AXE-jp/ros2rapper/src/ether/verilog-ethernet/verilog_ethernet.v

// Copyright (c) 2021-2024 AXE, Inc.
// SPDX-License-Identifier: GPL-3.0-or-later

`resetall
`default_nettype none

`include "ros2_ether_config.vh"

module verilog_ethernet (
    input  wire        clk,
    input  wire        rst_n,
    input  wire        enable,

    input  wire        phy_rx_clk,
    input  wire [3:0]  phy_rxd,
    input  wire        phy_rx_dv,
    input  wire        phy_rx_er,
    input  wire        phy_tx_clk,
    output wire [3:0]  phy_txd,
    output wire        phy_tx_en,
    output wire        phy_reset_n,

    input  wire        tx_udp_hdr_valid,
    output wire        tx_udp_hdr_ready,
    input  wire [5:0]  tx_udp_ip_dscp,
    input  wire [1:0]  tx_udp_ip_ecn,
    input  wire [15:0] tx_udp_ip_length,
    input  wire [7:0]  tx_udp_ip_ttl,
    input  wire [7:0]  tx_udp_ip_protocol,
    input  wire [31:0] tx_udp_ip_source_ip,
    input  wire [31:0] tx_udp_ip_dest_ip,
    input  wire [15:0] tx_udp_source_port,
    input  wire [15:0] tx_udp_dest_port,
    input  wire [15:0] tx_udp_length,
    input  wire [15:0] tx_udp_checksum,
    input  wire [7:0]  tx_udp_payload_axis_tdata,
    input  wire        tx_udp_payload_axis_tvalid,
    output wire        tx_udp_payload_axis_tready,
    input  wire        tx_udp_payload_axis_tlast,
    input  wire        tx_udp_payload_axis_tuser,

    output wire        rx_ip_hdr_valid,
    input  wire        rx_ip_hdr_ready,
    output wire [3:0]  rx_ip_version,
    output wire [3:0]  rx_ip_ihl,
    output wire [5:0]  rx_ip_dscp,
    output wire [1:0]  rx_ip_ecn,
    output wire [15:0] rx_ip_length,
    output wire [15:0] rx_ip_identification,
    output wire [2:0]  rx_ip_flags,
    output wire [12:0] rx_ip_fragment_offset,
    output wire [7:0]  rx_ip_ttl,
    output wire [7:0]  rx_ip_protocol,
    output wire [15:0] rx_ip_header_checksum,
    output wire [31:0] rx_ip_source_ip,
    output wire [31:0] rx_ip_dest_ip,
    output wire [7:0]  rx_ip_payload_axis_tdata,
    output wire        rx_ip_payload_axis_tvalid,
    input  wire        rx_ip_payload_axis_tready,
    output wire        rx_ip_payload_axis_tlast,
    output wire        rx_ip_payload_axis_tuser,

    input  wire [7:0]  tx_raw_eth_axis_tdata,
    input  wire        tx_raw_eth_axis_tvalid,
    output wire        tx_raw_eth_axis_tready,
    input  wire        tx_raw_eth_axis_tlast,

    input  wire        tx_raw_eth_ip_hdr_valid,
    output wire        tx_raw_eth_ip_hdr_ready,
    input  wire [5:0]  tx_raw_eth_ip_dscp,
    input  wire [1:0]  tx_raw_eth_ip_ecn,
    input  wire [15:0] tx_raw_eth_ip_length,
    input  wire [7:0]  tx_raw_eth_ip_ttl,
    input  wire [7:0]  tx_raw_eth_ip_protocol,
    input  wire [31:0] tx_raw_eth_ip_source_ip,
    input  wire [31:0] tx_raw_eth_ip_dest_ip,
    input  wire [7:0]  tx_raw_eth_ip_payload_axis_tdata,
    input  wire        tx_raw_eth_ip_payload_axis_tvalid,
    output wire        tx_raw_eth_ip_payload_axis_tready,
    input  wire        tx_raw_eth_ip_payload_axis_tlast,

    input  wire        select_tx_raw_eth_axis,
    input  wire        select_tx_raw_eth_ip,

    output wire [7:0]  rx_raw_eth_axis_tdata,
    output wire        rx_raw_eth_axis_tvalid,
    input  wire        rx_raw_eth_axis_tready,
    output wire        rx_raw_eth_axis_tlast,
    output wire        rx_raw_eth_axis_tuser,

    input  wire [47:0] local_mac,
    input  wire [31:0] local_ip,
    input  wire [31:0] gateway_ip,
    input  wire [31:0] subnet_mask,

    input  wire [5:0] arp_req_retry_count,
    input  wire [35:0] arp_req_retry_interval,
    input  wire [35:0] arp_req_timeout
);

wire [7:0] rx_axis_tdata;
wire rx_axis_tvalid;
wire rx_axis_tready;
wire rx_axis_tlast;
wire rx_axis_tuser;

wire [7:0] rx_ros2_axis_tdata;
wire rx_ros2_axis_tvalid;
wire rx_ros2_axis_tready;
wire rx_ros2_axis_tlast;
wire rx_ros2_axis_tuser;

wire [7:0] tx_axis_tdata;
wire tx_axis_tvalid;
wire tx_axis_tready;
wire tx_axis_tlast;
wire tx_axis_tuser;

wire [7:0] tx_ros2_axis_tdata;
wire tx_ros2_axis_tvalid;
wire tx_ros2_axis_tready;
wire tx_ros2_axis_tlast;
wire tx_ros2_axis_tuser;

wire rx_eth_hdr_ready;
wire rx_eth_hdr_valid;
wire [47:0] rx_eth_dest_mac;
wire [47:0] rx_eth_src_mac;
wire [15:0] rx_eth_type;
wire [7:0] rx_eth_payload_axis_tdata;
wire rx_eth_payload_axis_tvalid;
wire rx_eth_payload_axis_tready;
wire rx_eth_payload_axis_tlast;
wire rx_eth_payload_axis_tuser;

wire tx_eth_hdr_ready;
wire tx_eth_hdr_valid;
wire [47:0] tx_eth_dest_mac;
wire [47:0] tx_eth_src_mac;
wire [15:0] tx_eth_type;
wire [7:0] tx_eth_payload_axis_tdata;
wire tx_eth_payload_axis_tvalid;
wire tx_eth_payload_axis_tready;
wire tx_eth_payload_axis_tlast;
wire tx_eth_payload_axis_tuser;

wire [47:0] rx_ip_eth_dest_mac;
wire [47:0] rx_ip_eth_src_mac;
wire [15:0] rx_ip_eth_type;

assign phy_reset_n = rst_n;

eth_mac_mii_fifo #(
    .TX_FIFO_DEPTH(`MAC_TX_FIFO_DEPTH),
    .RX_FIFO_DEPTH(`MAC_RX_FIFO_DEPTH)
)
eth_mac_inst (
    .rst_n(rst_n),
    .logic_clk(clk),
    .logic_rst_n(rst_n),
    .logic_enable(enable),

    .tx_axis_tdata(tx_axis_tdata),
    .tx_axis_tvalid(tx_axis_tvalid),
    .tx_axis_tready(tx_axis_tready),
    .tx_axis_tlast(tx_axis_tlast),
    .tx_axis_tuser(tx_axis_tuser),
    .tx_axis_tkeep(1'b1),

    .rx_axis_tdata(rx_axis_tdata),
    .rx_axis_tvalid(rx_axis_tvalid),
    .rx_axis_tready(rx_axis_tready),
    .rx_axis_tlast(rx_axis_tlast),
    .rx_axis_tuser(rx_axis_tuser),
    .rx_axis_tkeep(),

    .mii_rx_clk(phy_rx_clk),
    .mii_rxd(phy_rxd),
    .mii_rx_dv(phy_rx_dv),
    .mii_rx_er(phy_rx_er),
    .mii_tx_clk(phy_tx_clk),
    .mii_txd(phy_txd),
    .mii_tx_en(phy_tx_en),
    .mii_tx_er(),

    .tx_error_underflow(),
    .tx_fifo_overflow(),
    .tx_fifo_bad_frame(),
    .tx_fifo_good_frame(),
    .rx_error_bad_frame(),
    .rx_error_bad_fcs(),
    .rx_fifo_overflow(),
    .rx_fifo_bad_frame(),
    .rx_fifo_good_frame(),

    .ifg_delay(8'd12)
);

eth_axis_rx
eth_axis_rx_inst (
    .clk(clk),
    .rst_n(rst_n),

    .s_axis_tdata(rx_ros2_axis_tdata),
    .s_axis_tkeep(1'b1),
    .s_axis_tvalid(rx_ros2_axis_tvalid),
    .s_axis_tready(rx_ros2_axis_tready),
    .s_axis_tlast(rx_ros2_axis_tlast),
    .s_axis_tuser(rx_ros2_axis_tuser),

    .m_eth_hdr_valid(rx_eth_hdr_valid),
    .m_eth_hdr_ready(rx_eth_hdr_ready),
    .m_eth_dest_mac(rx_eth_dest_mac),
    .m_eth_src_mac(rx_eth_src_mac),
    .m_eth_type(rx_eth_type),
    .m_eth_payload_axis_tdata(rx_eth_payload_axis_tdata),
    .m_eth_payload_axis_tvalid(rx_eth_payload_axis_tvalid),
    .m_eth_payload_axis_tready(rx_eth_payload_axis_tready),
    .m_eth_payload_axis_tlast(rx_eth_payload_axis_tlast),
    .m_eth_payload_axis_tuser(rx_eth_payload_axis_tuser),
    .m_eth_payload_axis_tkeep(),

    .busy(),
    .error_header_early_termination()
);

axis_broadcast #(
    .M_COUNT(2),
    .DATA_WIDTH(8),
    .KEEP_ENABLE(0),
    .KEEP_WIDTH(1),
    .LAST_ENABLE(1),
    .ID_ENABLE(0),
    .ID_WIDTH(8),
    .DEST_ENABLE(0),
    .DEST_WIDTH(8),
    .USER_ENABLE(1),
    .USER_WIDTH(1)
)
axis_broadcast_inst (
    .clk(clk),
    .rst_n(rst_n),

    .s_axis_tdata(rx_axis_tdata),
    .s_axis_tkeep(1'b1),
    .s_axis_tvalid(rx_axis_tvalid),
    .s_axis_tready(rx_axis_tready),
    .s_axis_tlast(rx_axis_tlast),
    .s_axis_tid(8'd0),
    .s_axis_tdest(8'd0),
    .s_axis_tuser(rx_axis_tuser),

    .m_axis_tdata({rx_raw_eth_axis_tdata, rx_ros2_axis_tdata}),
    .m_axis_tkeep(),
    .m_axis_tvalid({rx_raw_eth_axis_tvalid, rx_ros2_axis_tvalid}),
    .m_axis_tready({rx_raw_eth_axis_tready, rx_ros2_axis_tready}),
    .m_axis_tlast({rx_raw_eth_axis_tlast, rx_ros2_axis_tlast}),
    .m_axis_tid(),
    .m_axis_tdest(),
    .m_axis_tuser({rx_raw_eth_axis_tuser, rx_ros2_axis_tuser})
);

eth_axis_tx
eth_axis_tx_inst (
    .clk(clk),
    .rst_n(rst_n),

    .s_eth_hdr_valid(tx_eth_hdr_valid),
    .s_eth_hdr_ready(tx_eth_hdr_ready),
    .s_eth_dest_mac(tx_eth_dest_mac),
    .s_eth_src_mac(tx_eth_src_mac),
    .s_eth_type(tx_eth_type),
    .s_eth_payload_axis_tdata(tx_eth_payload_axis_tdata),
    .s_eth_payload_axis_tkeep(1'b1),
    .s_eth_payload_axis_tvalid(tx_eth_payload_axis_tvalid),
    .s_eth_payload_axis_tready(tx_eth_payload_axis_tready),
    .s_eth_payload_axis_tlast(tx_eth_payload_axis_tlast),
    .s_eth_payload_axis_tuser(tx_eth_payload_axis_tuser),

    .m_axis_tdata(tx_ros2_axis_tdata),
    .m_axis_tvalid(tx_ros2_axis_tvalid),
    .m_axis_tready(tx_ros2_axis_tready),
    .m_axis_tlast(tx_ros2_axis_tlast),
    .m_axis_tuser(tx_ros2_axis_tuser),
    .m_axis_tkeep(),

    .busy()
);

// 0: ROS2rapper, 1: raw ether
axis_mux #(
    .S_COUNT(2),
    .DATA_WIDTH(8),
    .KEEP_ENABLE(0),
    .KEEP_WIDTH(1),
    .ID_ENABLE(0),
    .ID_WIDTH(8),
    .DEST_ENABLE(0),
    .DEST_WIDTH(8),
    .USER_ENABLE(1),
    .USER_WIDTH(1)
)
axis_mux_inst (
    .clk(clk),
    .rst_n(rst_n),

    .s_axis_tdata({tx_raw_eth_axis_tdata, tx_ros2_axis_tdata}),
    .s_axis_tkeep(2'd0),
    .s_axis_tvalid({tx_raw_eth_axis_tvalid, tx_ros2_axis_tvalid}),
    .s_axis_tready({tx_raw_eth_axis_tready, tx_ros2_axis_tready}),
    .s_axis_tlast({tx_raw_eth_axis_tlast, tx_ros2_axis_tlast}),
    .s_axis_tid(16'd0),
    .s_axis_tdest(16'd0),
    .s_axis_tuser({1'b0, tx_ros2_axis_tuser}),

    .m_axis_tdata(tx_axis_tdata),
    .m_axis_tkeep(),
    .m_axis_tvalid(tx_axis_tvalid),
    .m_axis_tready(tx_axis_tready),
    .m_axis_tlast(tx_axis_tlast),
    .m_axis_tid(),
    .m_axis_tdest(),
    .m_axis_tuser(tx_axis_tuser),

    .enable(enable),
    .select(select_tx_raw_eth_axis)
);

wire        udp_hdr_valid;
wire        udp_hdr_ready;
wire [47:0] udp_eth_dest_mac;
wire [47:0] udp_eth_src_mac;
wire [15:0] udp_eth_type;
wire [3:0]  udp_ip_version;
wire [3:0]  udp_ip_ihl;
wire [5:0]  udp_ip_dscp;
wire [1:0]  udp_ip_ecn;
wire [15:0] udp_ip_length;
wire [15:0] udp_ip_identification;
wire [2:0]  udp_ip_flags;
wire [12:0] udp_ip_fragment_offset;
wire [7:0]  udp_ip_ttl;
wire [7:0]  udp_ip_protocol;
wire [15:0] udp_ip_header_checksum;
wire [31:0] udp_ip_source_ip;
wire [31:0] udp_ip_dest_ip;
wire [15:0] udp_source_port;
wire [15:0] udp_dest_port;
wire [15:0] udp_length;
wire [15:0] udp_checksum;
wire [7:0]  udp_payload_axis_tdata;
wire        udp_payload_axis_tvalid;
wire        udp_payload_axis_tready;
wire        udp_payload_axis_tlast;
wire        udp_payload_axis_tuser;

wire        tx_ros2_ip_hdr_valid;
wire        tx_ros2_ip_hdr_ready;
wire [5:0]  tx_ros2_ip_dscp;
wire [1:0]  tx_ros2_ip_ecn;
wire [15:0] tx_ros2_ip_length;
wire [7:0]  tx_ros2_ip_ttl;
wire [7:0]  tx_ros2_ip_protocol;
wire [31:0] tx_ros2_ip_source_ip;
wire [31:0] tx_ros2_ip_dest_ip;
wire [7:0]  tx_ros2_ip_payload_axis_tdata;
wire        tx_ros2_ip_payload_axis_tvalid;
wire        tx_ros2_ip_payload_axis_tready;
wire        tx_ros2_ip_payload_axis_tlast;
wire        tx_ros2_ip_payload_axis_tuser;

wire        tx_ip_hdr_valid;
wire        tx_ip_hdr_ready;
wire [5:0]  tx_ip_dscp;
wire [1:0]  tx_ip_ecn;
wire [15:0] tx_ip_length;
wire [7:0]  tx_ip_ttl;
wire [7:0]  tx_ip_protocol;
wire [31:0] tx_ip_source_ip;
wire [31:0] tx_ip_dest_ip;
wire [7:0]  tx_ip_payload_axis_tdata;
wire        tx_ip_payload_axis_tvalid;
wire        tx_ip_payload_axis_tready;
wire        tx_ip_payload_axis_tlast;
wire        tx_ip_payload_axis_tuser;

udp_checksum_gen #(
    .PAYLOAD_FIFO_DEPTH(`UDP_PAYLOAD_FIFO_DEPTH),
    .HEADER_FIFO_DEPTH(`UDP_HEADER_FIFO_DEPTH)
)
udp_checksum_gen_inst (
    .clk(clk),
    .rst_n(rst_n),

    .s_udp_hdr_valid(tx_udp_hdr_valid),
    .s_udp_hdr_ready(tx_udp_hdr_ready),
    .s_eth_dest_mac(48'd0),
    .s_eth_src_mac(48'd0),
    .s_eth_type(16'd0),
    .s_ip_version(4'd0),
    .s_ip_ihl(4'd0),
    .s_ip_dscp(tx_udp_ip_dscp),
    .s_ip_ecn(tx_udp_ip_ecn),
    .s_ip_identification(16'd0),
    .s_ip_flags(3'd0),
    .s_ip_fragment_offset(13'd0),
    .s_ip_ttl(tx_udp_ip_ttl),
    .s_ip_header_checksum(16'd0),
    .s_ip_source_ip(tx_udp_ip_source_ip),
    .s_ip_dest_ip(tx_udp_ip_dest_ip),
    .s_udp_source_port(tx_udp_source_port),
    .s_udp_dest_port(tx_udp_dest_port),
    .s_udp_payload_axis_tdata(tx_udp_payload_axis_tdata),
    .s_udp_payload_axis_tvalid(tx_udp_payload_axis_tvalid),
    .s_udp_payload_axis_tready(tx_udp_payload_axis_tready),
    .s_udp_payload_axis_tlast(tx_udp_payload_axis_tlast),
    .s_udp_payload_axis_tuser(tx_udp_payload_axis_tuser),

    .m_udp_hdr_valid(udp_hdr_valid),
    .m_udp_hdr_ready(udp_hdr_ready),
    .m_eth_dest_mac(udp_eth_dest_mac),
    .m_eth_src_mac(udp_eth_src_mac),
    .m_eth_type(udp_eth_type),
    .m_ip_version(udp_ip_version),
    .m_ip_ihl(udp_ip_ihl),
    .m_ip_dscp(udp_ip_dscp),
    .m_ip_ecn(udp_ip_ecn),
    .m_ip_length(udp_ip_length),
    .m_ip_identification(udp_ip_identification),
    .m_ip_flags(udp_ip_flags),
    .m_ip_fragment_offset(udp_ip_fragment_offset),
    .m_ip_ttl(udp_ip_ttl),
    .m_ip_protocol(udp_ip_protocol),
    .m_ip_header_checksum(udp_ip_header_checksum),
    .m_ip_source_ip(udp_ip_source_ip),
    .m_ip_dest_ip(udp_ip_dest_ip),
    .m_udp_source_port(udp_source_port),
    .m_udp_dest_port(udp_dest_port),
    .m_udp_length(udp_length),
    .m_udp_checksum(udp_checksum),
    .m_udp_payload_axis_tdata(udp_payload_axis_tdata),
    .m_udp_payload_axis_tvalid(udp_payload_axis_tvalid),
    .m_udp_payload_axis_tready(udp_payload_axis_tready),
    .m_udp_payload_axis_tlast(udp_payload_axis_tlast),
    .m_udp_payload_axis_tuser(udp_payload_axis_tuser),

    .busy()
);

udp_ip_tx
udp_ip_tx_inst(
    .clk(clk),
    .rst_n(rst_n),

    .s_udp_hdr_valid(udp_hdr_valid),
    .s_udp_hdr_ready(udp_hdr_ready),
    .s_eth_dest_mac(udp_eth_dest_mac),
    .s_eth_src_mac(udp_eth_src_mac),
    .s_eth_type(udp_eth_type),
    .s_ip_version(udp_ip_version),
    .s_ip_ihl(udp_ip_ihl),
    .s_ip_dscp(udp_ip_dscp),
    .s_ip_ecn(udp_ip_ecn),
    .s_ip_identification(udp_ip_identification),
    .s_ip_flags(udp_ip_flags),
    .s_ip_fragment_offset(udp_ip_fragment_offset),
    .s_ip_ttl(udp_ip_ttl),
    .s_ip_protocol(udp_ip_protocol),
    .s_ip_header_checksum(udp_ip_header_checksum),
    .s_ip_source_ip(udp_ip_source_ip),
    .s_ip_dest_ip(udp_ip_dest_ip),
    .s_udp_source_port(udp_source_port),
    .s_udp_dest_port(udp_dest_port),
    .s_udp_length(udp_length),
    .s_udp_checksum(udp_checksum),
    .s_udp_payload_axis_tdata(udp_payload_axis_tdata),
    .s_udp_payload_axis_tvalid(udp_payload_axis_tvalid),
    .s_udp_payload_axis_tready(udp_payload_axis_tready),
    .s_udp_payload_axis_tlast(udp_payload_axis_tlast),
    .s_udp_payload_axis_tuser(udp_payload_axis_tuser),

    .m_ip_hdr_valid(tx_ros2_ip_hdr_valid),
    .m_ip_hdr_ready(tx_ros2_ip_hdr_ready),
    .m_eth_dest_mac(),
    .m_eth_src_mac(),
    .m_eth_type(),
    .m_ip_version(),
    .m_ip_ihl(),
    .m_ip_dscp(tx_ros2_ip_dscp),
    .m_ip_ecn(tx_ros2_ip_ecn),
    .m_ip_length(tx_ros2_ip_length),
    .m_ip_identification(),
    .m_ip_flags(),
    .m_ip_fragment_offset(),
    .m_ip_ttl(tx_ros2_ip_ttl),
    .m_ip_protocol(tx_ros2_ip_protocol),
    .m_ip_header_checksum(),
    .m_ip_source_ip(tx_ros2_ip_source_ip),
    .m_ip_dest_ip(tx_ros2_ip_dest_ip),
    .m_ip_payload_axis_tdata(tx_ros2_ip_payload_axis_tdata),
    .m_ip_payload_axis_tvalid(tx_ros2_ip_payload_axis_tvalid),
    .m_ip_payload_axis_tready(tx_ros2_ip_payload_axis_tready),
    .m_ip_payload_axis_tlast(tx_ros2_ip_payload_axis_tlast),
    .m_ip_payload_axis_tuser(tx_ros2_ip_payload_axis_tuser),

    .busy(),
    .error_payload_early_termination()
);

// 0: ROS2rapper, 1: raw ether
ip_mux #(
    .S_COUNT(2),
    .DATA_WIDTH(8),
    .KEEP_ENABLE(0),
    .KEEP_WIDTH(1),
    .ID_ENABLE(0),
    .ID_WIDTH(8),
    .DEST_ENABLE(0),
    .DEST_WIDTH(8),
    .USER_ENABLE(1),
    .USER_WIDTH(1)
)
ip_mux_inst (
    .clk(clk),
    .rst_n(rst_n),

    .s_ip_hdr_valid({tx_raw_eth_ip_hdr_valid, tx_ros2_ip_hdr_valid}),
    .s_ip_hdr_ready({tx_raw_eth_ip_hdr_ready, tx_ros2_ip_hdr_ready}),
    .s_eth_dest_mac(96'd0),
    .s_eth_src_mac(96'd0),
    .s_eth_type(32'd0),
    .s_ip_version(8'd0),
    .s_ip_ihl(8'd0),
    .s_ip_dscp({tx_raw_eth_ip_dscp, tx_ros2_ip_dscp}),
    .s_ip_ecn({tx_raw_eth_ip_ecn, tx_ros2_ip_ecn}),
    .s_ip_length({tx_raw_eth_ip_length, tx_ros2_ip_length}),
    .s_ip_identification(32'd0),
    .s_ip_flags(6'd0),
    .s_ip_fragment_offset(26'd0),
    .s_ip_ttl({tx_raw_eth_ip_ttl, tx_ros2_ip_ttl}),
    .s_ip_protocol({tx_raw_eth_ip_protocol, tx_ros2_ip_protocol}),
    .s_ip_header_checksum(32'd0),
    .s_ip_source_ip({tx_raw_eth_ip_source_ip, tx_ros2_ip_source_ip}),
    .s_ip_dest_ip({tx_raw_eth_ip_dest_ip, tx_ros2_ip_dest_ip}),
    .s_ip_payload_axis_tdata({tx_raw_eth_ip_payload_axis_tdata, tx_ros2_ip_payload_axis_tdata}),
    .s_ip_payload_axis_tkeep(2'd0),
    .s_ip_payload_axis_tvalid({tx_raw_eth_ip_payload_axis_tvalid, tx_ros2_ip_payload_axis_tvalid}),
    .s_ip_payload_axis_tready({tx_raw_eth_ip_payload_axis_tready, tx_ros2_ip_payload_axis_tready}),
    .s_ip_payload_axis_tlast({tx_raw_eth_ip_payload_axis_tlast, tx_ros2_ip_payload_axis_tlast}),
    .s_ip_payload_axis_tid(16'd0),
    .s_ip_payload_axis_tdest(16'd0),
    .s_ip_payload_axis_tuser({1'b0, tx_ros2_ip_payload_axis_tuser}),

    .m_ip_hdr_valid(tx_ip_hdr_valid),
    .m_ip_hdr_ready(tx_ip_hdr_ready),
    .m_eth_dest_mac(),
    .m_eth_src_mac(),
    .m_eth_type(),
    .m_ip_version(),
    .m_ip_ihl(),
    .m_ip_dscp(tx_ip_dscp),
    .m_ip_ecn(tx_ip_ecn),
    .m_ip_length(tx_ip_length),
    .m_ip_identification(),
    .m_ip_flags(),
    .m_ip_fragment_offset(),
    .m_ip_ttl(tx_ip_ttl),
    .m_ip_protocol(tx_ip_protocol),
    .m_ip_header_checksum(),
    .m_ip_source_ip(tx_ip_source_ip),
    .m_ip_dest_ip(tx_ip_dest_ip),
    .m_ip_payload_axis_tdata(tx_ip_payload_axis_tdata),
    .m_ip_payload_axis_tkeep(),
    .m_ip_payload_axis_tvalid(tx_ip_payload_axis_tvalid),
    .m_ip_payload_axis_tready(tx_ip_payload_axis_tready),
    .m_ip_payload_axis_tlast(tx_ip_payload_axis_tlast),
    .m_ip_payload_axis_tid(),
    .m_ip_payload_axis_tdest(),
    .m_ip_payload_axis_tuser(tx_ip_payload_axis_tuser),

    .enable(enable),
    .select(select_tx_raw_eth_ip)
);

ip_complete #(
    .ARP_CACHE_ADDR_WIDTH(`ARP_CACHE_ADDR_WIDTH)
)
ip_complete_inst (
    .clk(clk),
    .rst_n(rst_n),

    .s_eth_hdr_valid(rx_eth_hdr_valid),
    .s_eth_hdr_ready(rx_eth_hdr_ready),
    .s_eth_dest_mac(rx_eth_dest_mac),
    .s_eth_src_mac(rx_eth_src_mac),
    .s_eth_type(rx_eth_type),
    .s_eth_payload_axis_tdata(rx_eth_payload_axis_tdata),
    .s_eth_payload_axis_tvalid(rx_eth_payload_axis_tvalid),
    .s_eth_payload_axis_tready(rx_eth_payload_axis_tready),
    .s_eth_payload_axis_tlast(rx_eth_payload_axis_tlast),
    .s_eth_payload_axis_tuser(rx_eth_payload_axis_tuser),

    .m_eth_hdr_valid(tx_eth_hdr_valid),
    .m_eth_hdr_ready(tx_eth_hdr_ready),
    .m_eth_dest_mac(tx_eth_dest_mac),
    .m_eth_src_mac(tx_eth_src_mac),
    .m_eth_type(tx_eth_type),
    .m_eth_payload_axis_tdata(tx_eth_payload_axis_tdata),
    .m_eth_payload_axis_tvalid(tx_eth_payload_axis_tvalid),
    .m_eth_payload_axis_tready(tx_eth_payload_axis_tready),
    .m_eth_payload_axis_tlast(tx_eth_payload_axis_tlast),
    .m_eth_payload_axis_tuser(tx_eth_payload_axis_tuser),

    .s_ip_hdr_valid(tx_ip_hdr_valid),
    .s_ip_hdr_ready(tx_ip_hdr_ready),
    .s_ip_dscp(tx_ip_dscp),
    .s_ip_ecn(tx_ip_ecn),
    .s_ip_length(tx_ip_length),
    .s_ip_ttl(tx_ip_ttl),
    .s_ip_protocol(tx_ip_protocol),
    .s_ip_source_ip(tx_ip_source_ip),
    .s_ip_dest_ip(tx_ip_dest_ip),
    .s_ip_payload_axis_tdata(tx_ip_payload_axis_tdata),
    .s_ip_payload_axis_tvalid(tx_ip_payload_axis_tvalid),
    .s_ip_payload_axis_tready(tx_ip_payload_axis_tready),
    .s_ip_payload_axis_tlast(tx_ip_payload_axis_tlast),
    .s_ip_payload_axis_tuser(tx_ip_payload_axis_tuser),

    .m_ip_hdr_valid(rx_ip_hdr_valid),
    .m_ip_hdr_ready(rx_ip_hdr_ready),
    .m_ip_eth_dest_mac(rx_ip_eth_dest_mac),
    .m_ip_eth_src_mac(rx_ip_eth_src_mac),
    .m_ip_eth_type(rx_ip_eth_type),
    .m_ip_version(rx_ip_version),
    .m_ip_ihl(rx_ip_ihl),
    .m_ip_dscp(rx_ip_dscp),
    .m_ip_ecn(rx_ip_ecn),
    .m_ip_length(rx_ip_length),
    .m_ip_identification(rx_ip_identification),
    .m_ip_flags(rx_ip_flags),
    .m_ip_fragment_offset(rx_ip_fragment_offset),
    .m_ip_ttl(rx_ip_ttl),
    .m_ip_protocol(rx_ip_protocol),
    .m_ip_header_checksum(rx_ip_header_checksum),
    .m_ip_source_ip(rx_ip_source_ip),
    .m_ip_dest_ip(rx_ip_dest_ip),
    .m_ip_payload_axis_tdata(rx_ip_payload_axis_tdata),
    .m_ip_payload_axis_tvalid(rx_ip_payload_axis_tvalid),
    .m_ip_payload_axis_tready(rx_ip_payload_axis_tready),
    .m_ip_payload_axis_tlast(rx_ip_payload_axis_tlast),
    .m_ip_payload_axis_tuser(rx_ip_payload_axis_tuser),

    .rx_busy(),
    .tx_busy(),
    .rx_error_header_early_termination(),
    .rx_error_payload_early_termination(),
    .rx_error_invalid_header(),
    .rx_error_invalid_checksum(),
    .tx_error_payload_early_termination(),
    .tx_error_arp_failed(),

    .local_mac(local_mac),
    .local_ip(local_ip),
    .gateway_ip(gateway_ip),
    .subnet_mask(subnet_mask),
    .clear_arp_cache(1'b0),

    .arp_req_retry_count(arp_req_retry_count),
    .arp_req_retry_interval(arp_req_retry_interval),
    .arp_req_timeout(arp_req_timeout)
);

endmodule

`resetall
