AXE-jp/ros2rapper/src/ether/verilog-ethernet/ip_mux.v

/*

Copyright (c) 2014-2018 Alex Forencich

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
*/

// Language: Verilog 2001

`resetall
`include "ros2_ether_config.vh"
`default_nettype none

/*
 * IP multiplexer
 */
module ip_mux #
(
    parameter S_COUNT = 4,
    parameter DATA_WIDTH = 8,
    parameter KEEP_ENABLE = (DATA_WIDTH>8),
    parameter KEEP_WIDTH = (DATA_WIDTH/8),
    parameter ID_ENABLE = 0,
    parameter ID_WIDTH = 8,
    parameter DEST_ENABLE = 0,
    parameter DEST_WIDTH = 8,
    parameter USER_ENABLE = 1,
    parameter USER_WIDTH = 1
)
(
    input  wire                          clk,
    input  wire                          rst_n,

    /*
     * IP frame inputs
     */
    input  wire [S_COUNT-1:0]            s_ip_hdr_valid,
    output wire [S_COUNT-1:0]            s_ip_hdr_ready,
    input  wire [S_COUNT*48-1:0]         s_eth_dest_mac,
    input  wire [S_COUNT*48-1:0]         s_eth_src_mac,
    input  wire [S_COUNT*16-1:0]         s_eth_type,
    input  wire [S_COUNT*4-1:0]          s_ip_version,
    input  wire [S_COUNT*4-1:0]          s_ip_ihl,
    input  wire [S_COUNT*6-1:0]          s_ip_dscp,
    input  wire [S_COUNT*2-1:0]          s_ip_ecn,
    input  wire [S_COUNT*16-1:0]         s_ip_length,
    input  wire [S_COUNT*16-1:0]         s_ip_identification,
    input  wire [S_COUNT*3-1:0]          s_ip_flags,
    input  wire [S_COUNT*13-1:0]         s_ip_fragment_offset,
    input  wire [S_COUNT*8-1:0]          s_ip_ttl,
    input  wire [S_COUNT*8-1:0]          s_ip_protocol,
    input  wire [S_COUNT*16-1:0]         s_ip_header_checksum,
    input  wire [S_COUNT*32-1:0]         s_ip_source_ip,
    input  wire [S_COUNT*32-1:0]         s_ip_dest_ip,
    input  wire [S_COUNT*DATA_WIDTH-1:0] s_ip_payload_axis_tdata,
    input  wire [S_COUNT*KEEP_WIDTH-1:0] s_ip_payload_axis_tkeep,
    input  wire [S_COUNT-1:0]            s_ip_payload_axis_tvalid,
    output wire [S_COUNT-1:0]            s_ip_payload_axis_tready,
    input  wire [S_COUNT-1:0]            s_ip_payload_axis_tlast,
    input  wire [S_COUNT*ID_WIDTH-1:0]   s_ip_payload_axis_tid,
    input  wire [S_COUNT*DEST_WIDTH-1:0] s_ip_payload_axis_tdest,
    input  wire [S_COUNT*USER_WIDTH-1:0] s_ip_payload_axis_tuser,

    /*
     * IP frame output
     */
    output wire                          m_ip_hdr_valid,
    input  wire                          m_ip_hdr_ready,
    output wire [47:0]                   m_eth_dest_mac,
    output wire [47:0]                   m_eth_src_mac,
    output wire [15:0]                   m_eth_type,
    output wire [3:0]                    m_ip_version,
    output wire [3:0]                    m_ip_ihl,
    output wire [5:0]                    m_ip_dscp,
    output wire [1:0]                    m_ip_ecn,
    output wire [15:0]                   m_ip_length,
    output wire [15:0]                   m_ip_identification,
    output wire [2:0]                    m_ip_flags,
    output wire [12:0]                   m_ip_fragment_offset,
    output wire [7:0]                    m_ip_ttl,
    output wire [7:0]                    m_ip_protocol,
    output wire [15:0]                   m_ip_header_checksum,
    output wire [31:0]                   m_ip_source_ip,
    output wire [31:0]                   m_ip_dest_ip,
    output wire [DATA_WIDTH-1:0]         m_ip_payload_axis_tdata,
    output wire [KEEP_WIDTH-1:0]         m_ip_payload_axis_tkeep,
    output wire                          m_ip_payload_axis_tvalid,
    input  wire                          m_ip_payload_axis_tready,
    output wire                          m_ip_payload_axis_tlast,
    output wire [ID_WIDTH-1:0]           m_ip_payload_axis_tid,
    output wire [DEST_WIDTH-1:0]         m_ip_payload_axis_tdest,
    output wire [USER_WIDTH-1:0]         m_ip_payload_axis_tuser,

    /*
     * Control
     */
    input  wire                          enable,
    input  wire [$clog2(S_COUNT)-1:0]    select
);

localparam CL_S_COUNT = $clog2(S_COUNT);

reg [CL_S_COUNT-1:0] select_reg, select_next;
reg frame_reg, frame_next;

reg [S_COUNT-1:0] s_ip_hdr_ready_reg, s_ip_hdr_ready_next;

reg [S_COUNT-1:0] s_ip_payload_axis_tready_reg, s_ip_payload_axis_tready_next;

reg m_ip_hdr_valid_reg, m_ip_hdr_valid_next;
reg [47:0] m_eth_dest_mac_reg, m_eth_dest_mac_next;
reg [47:0] m_eth_src_mac_reg, m_eth_src_mac_next;
reg [15:0] m_eth_type_reg, m_eth_type_next;
reg [3:0]  m_ip_version_reg, m_ip_version_next;
reg [3:0]  m_ip_ihl_reg, m_ip_ihl_next;
reg [5:0]  m_ip_dscp_reg, m_ip_dscp_next;
reg [1:0]  m_ip_ecn_reg, m_ip_ecn_next;
reg [15:0] m_ip_length_reg, m_ip_length_next;
reg [15:0] m_ip_identification_reg, m_ip_identification_next;
reg [2:0]  m_ip_flags_reg, m_ip_flags_next;
reg [12:0] m_ip_fragment_offset_reg, m_ip_fragment_offset_next;
reg [7:0]  m_ip_ttl_reg, m_ip_ttl_next;
reg [7:0]  m_ip_protocol_reg, m_ip_protocol_next;
reg [15:0] m_ip_header_checksum_reg, m_ip_header_checksum_next;
reg [31:0] m_ip_source_ip_reg, m_ip_source_ip_next;
reg [31:0] m_ip_dest_ip_reg, m_ip_dest_ip_next;

// internal datapath
reg  [DATA_WIDTH-1:0] m_ip_payload_axis_tdata_int;
reg  [KEEP_WIDTH-1:0] m_ip_payload_axis_tkeep_int;
reg                   m_ip_payload_axis_tvalid_int;
reg                   m_ip_payload_axis_tready_int_reg;
reg                   m_ip_payload_axis_tlast_int;
reg  [ID_WIDTH-1:0]   m_ip_payload_axis_tid_int;
reg  [DEST_WIDTH-1:0] m_ip_payload_axis_tdest_int;
reg  [USER_WIDTH-1:0] m_ip_payload_axis_tuser_int;
wire                  m_ip_payload_axis_tready_int_early;

assign s_ip_hdr_ready = s_ip_hdr_ready_reg;

assign s_ip_payload_axis_tready = s_ip_payload_axis_tready_reg;

assign m_ip_hdr_valid = m_ip_hdr_valid_reg;
assign m_eth_dest_mac = m_eth_dest_mac_reg;
assign m_eth_src_mac = m_eth_src_mac_reg;
assign m_eth_type = m_eth_type_reg;
assign m_ip_version = m_ip_version_reg;
assign m_ip_ihl = m_ip_ihl_reg;
assign m_ip_dscp = m_ip_dscp_reg;
assign m_ip_ecn = m_ip_ecn_reg;
assign m_ip_length = m_ip_length_reg;
assign m_ip_identification = m_ip_identification_reg;
assign m_ip_flags = m_ip_flags_reg;
assign m_ip_fragment_offset = m_ip_fragment_offset_reg;
assign m_ip_ttl = m_ip_ttl_reg;
assign m_ip_protocol = m_ip_protocol_reg;
assign m_ip_header_checksum = m_ip_header_checksum_reg;
assign m_ip_source_ip = m_ip_source_ip_reg;
assign m_ip_dest_ip = m_ip_dest_ip_reg;

// mux for incoming packet
wire [DATA_WIDTH-1:0] current_s_tdata  = s_ip_payload_axis_tdata[select_reg*DATA_WIDTH +: DATA_WIDTH];
wire [KEEP_WIDTH-1:0] current_s_tkeep  = s_ip_payload_axis_tkeep[select_reg*KEEP_WIDTH +: KEEP_WIDTH];
wire                  current_s_tvalid = s_ip_payload_axis_tvalid[select_reg];
wire                  current_s_tready = s_ip_payload_axis_tready[select_reg];
wire                  current_s_tlast  = s_ip_payload_axis_tlast[select_reg];
wire [ID_WIDTH-1:0]   current_s_tid    = s_ip_payload_axis_tid[select_reg*ID_WIDTH +: ID_WIDTH];
wire [DEST_WIDTH-1:0] current_s_tdest  = s_ip_payload_axis_tdest[select_reg*DEST_WIDTH +: DEST_WIDTH];
wire [USER_WIDTH-1:0] current_s_tuser  = s_ip_payload_axis_tuser[select_reg*USER_WIDTH +: USER_WIDTH];

always @* begin
    select_next = select_reg;
    frame_next = frame_reg;

    s_ip_hdr_ready_next = 0;

    s_ip_payload_axis_tready_next = 0;

    m_ip_hdr_valid_next = m_ip_hdr_valid_reg && !m_ip_hdr_ready;
    m_eth_dest_mac_next = m_eth_dest_mac_reg;
    m_eth_src_mac_next = m_eth_src_mac_reg;
    m_eth_type_next = m_eth_type_reg;
    m_ip_version_next = m_ip_version_reg;
    m_ip_ihl_next = m_ip_ihl_reg;
    m_ip_dscp_next = m_ip_dscp_reg;
    m_ip_ecn_next = m_ip_ecn_reg;
    m_ip_length_next = m_ip_length_reg;
    m_ip_identification_next = m_ip_identification_reg;
    m_ip_flags_next = m_ip_flags_reg;
    m_ip_fragment_offset_next = m_ip_fragment_offset_reg;
    m_ip_ttl_next = m_ip_ttl_reg;
    m_ip_protocol_next = m_ip_protocol_reg;
    m_ip_header_checksum_next = m_ip_header_checksum_reg;
    m_ip_source_ip_next = m_ip_source_ip_reg;
    m_ip_dest_ip_next = m_ip_dest_ip_reg;

    if (current_s_tvalid & current_s_tready) begin
        // end of frame detection
        if (current_s_tlast) begin
            frame_next = 1'b0;
        end
    end

    if (!frame_reg && enable && !m_ip_hdr_valid && (s_ip_hdr_valid & (1 << select))) begin
        // start of frame, grab select value
        frame_next = 1'b1;
        select_next = select;

        s_ip_hdr_ready_next = (1 << select);

        m_ip_hdr_valid_next = 1'b1;
        m_eth_dest_mac_next = s_eth_dest_mac[select*48 +: 48];
        m_eth_src_mac_next = s_eth_src_mac[select*48 +: 48];
        m_eth_type_next = s_eth_type[select*16 +: 16];
        m_ip_version_next = s_ip_version[select*4 +: 4];
        m_ip_ihl_next = s_ip_ihl[select*4 +: 4];
        m_ip_dscp_next = s_ip_dscp[select*6 +: 6];
        m_ip_ecn_next = s_ip_ecn[select*2 +: 2];
        m_ip_length_next = s_ip_length[select*16 +: 16];
        m_ip_identification_next = s_ip_identification[select*16 +: 16];
        m_ip_flags_next = s_ip_flags[select*3 +: 3];
        m_ip_fragment_offset_next = s_ip_fragment_offset[select*13 +: 13];
        m_ip_ttl_next = s_ip_ttl[select*8 +: 8];
        m_ip_protocol_next = s_ip_protocol[select*8 +: 8];
        m_ip_header_checksum_next = s_ip_header_checksum[select*16 +: 16];
        m_ip_source_ip_next = s_ip_source_ip[select*32 +: 32];
        m_ip_dest_ip_next = s_ip_dest_ip[select*32 +: 32];
    end

    // generate ready signal on selected port
    s_ip_payload_axis_tready_next = (m_ip_payload_axis_tready_int_early && frame_next) << select_next;

    // pass through selected packet data
    m_ip_payload_axis_tdata_int  = current_s_tdata;
    m_ip_payload_axis_tkeep_int  = current_s_tkeep;
    m_ip_payload_axis_tvalid_int = current_s_tvalid && current_s_tready && frame_reg;
    m_ip_payload_axis_tlast_int  = current_s_tlast;
    m_ip_payload_axis_tid_int    = current_s_tid;
    m_ip_payload_axis_tdest_int  = current_s_tdest;
    m_ip_payload_axis_tuser_int  = current_s_tuser;
end

always @(posedge clk or negedge rst_n) begin
    if (!rst_n) begin
        select_reg <= 0;
        frame_reg <= 1'b0;
        s_ip_hdr_ready_reg <= 0;
        s_ip_payload_axis_tready_reg <= 0;
        m_ip_hdr_valid_reg <= 1'b0;

        m_eth_dest_mac_reg <= 48'd0;
        m_eth_src_mac_reg <= 48'd0;
        m_eth_type_reg <= 16'd0;
        m_ip_version_reg <= 4'd0;
        m_ip_ihl_reg <= 4'd0;
        m_ip_dscp_reg <= 6'd0;
        m_ip_ecn_reg <= 2'd0;
        m_ip_length_reg <= 16'd0;
        m_ip_identification_reg <= 16'd0;
        m_ip_flags_reg <= 3'd0;
        m_ip_fragment_offset_reg <= 13'd0;
        m_ip_ttl_reg <= 8'd0;
        m_ip_protocol_reg <= 8'd0;
        m_ip_header_checksum_reg <= 16'd0;
        m_ip_source_ip_reg <= 32'd0;
        m_ip_dest_ip_reg <= 32'd0;
    end else begin
        select_reg <= select_next;
        frame_reg <= frame_next;
        s_ip_hdr_ready_reg <= s_ip_hdr_ready_next;
        s_ip_payload_axis_tready_reg <= s_ip_payload_axis_tready_next;
        m_ip_hdr_valid_reg <= m_ip_hdr_valid_next;

        m_eth_dest_mac_reg <= m_eth_dest_mac_next;
        m_eth_src_mac_reg <= m_eth_src_mac_next;
        m_eth_type_reg <= m_eth_type_next;
        m_ip_version_reg <= m_ip_version_next;
        m_ip_ihl_reg <= m_ip_ihl_next;
        m_ip_dscp_reg <= m_ip_dscp_next;
        m_ip_ecn_reg <= m_ip_ecn_next;
        m_ip_length_reg <= m_ip_length_next;
        m_ip_identification_reg <= m_ip_identification_next;
        m_ip_flags_reg <= m_ip_flags_next;
        m_ip_fragment_offset_reg <= m_ip_fragment_offset_next;
        m_ip_ttl_reg <= m_ip_ttl_next;
        m_ip_protocol_reg <= m_ip_protocol_next;
        m_ip_header_checksum_reg <= m_ip_header_checksum_next;
        m_ip_source_ip_reg <= m_ip_source_ip_next;
        m_ip_dest_ip_reg <= m_ip_dest_ip_next;
    end


end

// output datapath logic
reg [DATA_WIDTH-1:0] m_ip_payload_axis_tdata_reg;
reg [KEEP_WIDTH-1:0] m_ip_payload_axis_tkeep_reg;
reg                  m_ip_payload_axis_tvalid_reg, m_ip_payload_axis_tvalid_next;
reg                  m_ip_payload_axis_tlast_reg;
reg [ID_WIDTH-1:0]   m_ip_payload_axis_tid_reg;
reg [DEST_WIDTH-1:0] m_ip_payload_axis_tdest_reg;
reg [USER_WIDTH-1:0] m_ip_payload_axis_tuser_reg;

reg [DATA_WIDTH-1:0] temp_m_ip_payload_axis_tdata_reg;
reg [KEEP_WIDTH-1:0] temp_m_ip_payload_axis_tkeep_reg;
reg                  temp_m_ip_payload_axis_tvalid_reg, temp_m_ip_payload_axis_tvalid_next;
reg                  temp_m_ip_payload_axis_tlast_reg;
reg [ID_WIDTH-1:0]   temp_m_ip_payload_axis_tid_reg;
reg [DEST_WIDTH-1:0] temp_m_ip_payload_axis_tdest_reg;
reg [USER_WIDTH-1:0] temp_m_ip_payload_axis_tuser_reg;

// datapath control
reg store_axis_int_to_output;
reg store_axis_int_to_temp;
reg store_axis_temp_to_output;

assign m_ip_payload_axis_tdata  = m_ip_payload_axis_tdata_reg;
assign m_ip_payload_axis_tkeep  = KEEP_ENABLE ? m_ip_payload_axis_tkeep_reg : {KEEP_WIDTH{1'b1}};
assign m_ip_payload_axis_tvalid = m_ip_payload_axis_tvalid_reg;
assign m_ip_payload_axis_tlast  = m_ip_payload_axis_tlast_reg;
assign m_ip_payload_axis_tid    = ID_ENABLE   ? m_ip_payload_axis_tid_reg   : {ID_WIDTH{1'b0}};
assign m_ip_payload_axis_tdest  = DEST_ENABLE ? m_ip_payload_axis_tdest_reg : {DEST_WIDTH{1'b0}};
assign m_ip_payload_axis_tuser  = USER_ENABLE ? m_ip_payload_axis_tuser_reg : {USER_WIDTH{1'b0}};

// enable ready input next cycle if output is ready or if both output registers are empty
assign m_ip_payload_axis_tready_int_early = m_ip_payload_axis_tready || (!temp_m_ip_payload_axis_tvalid_reg && !m_ip_payload_axis_tvalid_reg);

always @* begin
    // transfer sink ready state to source
    m_ip_payload_axis_tvalid_next = m_ip_payload_axis_tvalid_reg;
    temp_m_ip_payload_axis_tvalid_next = temp_m_ip_payload_axis_tvalid_reg;

    store_axis_int_to_output = 1'b0;
    store_axis_int_to_temp = 1'b0;
    store_axis_temp_to_output = 1'b0;

    if (m_ip_payload_axis_tready_int_reg) begin
        // input is ready
        if (m_ip_payload_axis_tready || !m_ip_payload_axis_tvalid_reg) begin
            // output is ready or currently not valid, transfer data to output
            m_ip_payload_axis_tvalid_next = m_ip_payload_axis_tvalid_int;
            store_axis_int_to_output = 1'b1;
        end else begin
            // output is not ready, store input in temp
            temp_m_ip_payload_axis_tvalid_next = m_ip_payload_axis_tvalid_int;
            store_axis_int_to_temp = 1'b1;
        end
    end else if (m_ip_payload_axis_tready) begin
        // input is not ready, but output is ready
        m_ip_payload_axis_tvalid_next = temp_m_ip_payload_axis_tvalid_reg;
        temp_m_ip_payload_axis_tvalid_next = 1'b0;
        store_axis_temp_to_output = 1'b1;
    end
end

always @(posedge clk or negedge rst_n) begin
    if (!rst_n) begin
        m_ip_payload_axis_tvalid_reg <= 1'b0;
        m_ip_payload_axis_tready_int_reg <= 1'b0;
        temp_m_ip_payload_axis_tvalid_reg <= 1'b0;

        m_ip_payload_axis_tdata_reg <= {DATA_WIDTH{1'b0}};
        m_ip_payload_axis_tkeep_reg <= {KEEP_WIDTH{1'b0}};
        m_ip_payload_axis_tlast_reg <= 1'b0;
        m_ip_payload_axis_tid_reg   <= {ID_WIDTH{1'b0}};
        m_ip_payload_axis_tdest_reg <= {DEST_WIDTH{1'b0}};
        m_ip_payload_axis_tuser_reg <= {USER_WIDTH{1'b0}};

        temp_m_ip_payload_axis_tdata_reg <= {DATA_WIDTH{1'b0}};
        temp_m_ip_payload_axis_tkeep_reg <= {KEEP_WIDTH{1'b0}};
        temp_m_ip_payload_axis_tlast_reg <= 1'b0;
        temp_m_ip_payload_axis_tid_reg   <= {ID_WIDTH{1'b0}};
        temp_m_ip_payload_axis_tdest_reg <= {DEST_WIDTH{1'b0}};
        temp_m_ip_payload_axis_tuser_reg <= {USER_WIDTH{1'b0}};
    end else begin
        m_ip_payload_axis_tvalid_reg <= m_ip_payload_axis_tvalid_next;
        m_ip_payload_axis_tready_int_reg <= m_ip_payload_axis_tready_int_early;
        temp_m_ip_payload_axis_tvalid_reg <= temp_m_ip_payload_axis_tvalid_next;

        // datapath
        if (store_axis_int_to_output) begin
            m_ip_payload_axis_tdata_reg <= m_ip_payload_axis_tdata_int;
            m_ip_payload_axis_tkeep_reg <= m_ip_payload_axis_tkeep_int;
            m_ip_payload_axis_tlast_reg <= m_ip_payload_axis_tlast_int;
            m_ip_payload_axis_tid_reg   <= m_ip_payload_axis_tid_int;
            m_ip_payload_axis_tdest_reg <= m_ip_payload_axis_tdest_int;
            m_ip_payload_axis_tuser_reg <= m_ip_payload_axis_tuser_int;
        end else if (store_axis_temp_to_output) begin
            m_ip_payload_axis_tdata_reg <= temp_m_ip_payload_axis_tdata_reg;
            m_ip_payload_axis_tkeep_reg <= temp_m_ip_payload_axis_tkeep_reg;
            m_ip_payload_axis_tlast_reg <= temp_m_ip_payload_axis_tlast_reg;
            m_ip_payload_axis_tid_reg   <= temp_m_ip_payload_axis_tid_reg;
            m_ip_payload_axis_tdest_reg <= temp_m_ip_payload_axis_tdest_reg;
            m_ip_payload_axis_tuser_reg <= temp_m_ip_payload_axis_tuser_reg;
        end

        if (store_axis_int_to_temp) begin
            temp_m_ip_payload_axis_tdata_reg <= m_ip_payload_axis_tdata_int;
            temp_m_ip_payload_axis_tkeep_reg <= m_ip_payload_axis_tkeep_int;
            temp_m_ip_payload_axis_tlast_reg <= m_ip_payload_axis_tlast_int;
            temp_m_ip_payload_axis_tid_reg   <= m_ip_payload_axis_tid_int;
            temp_m_ip_payload_axis_tdest_reg <= m_ip_payload_axis_tdest_int;
            temp_m_ip_payload_axis_tuser_reg <= m_ip_payload_axis_tuser_int;
        end
    end
end

endmodule

`resetall
