AXE-jp/ros2rapper/(commit log)

2021-12-17 fix header for newer version of Vitis
    [hls.hpp]
2022-08-24 Use FIFO interface ethernet instead of SLIP
    [ros2.cpp]
2022-11-18 add ad hoc error report
    [ip.cpp]
2022-11-21 fix deadlock bug about fifo
    [ip.cpp, ros2.cpp]
2022-11-22 change MAX_IP_FRAGMENTS to 2, fix array index calc not to infer DSPs.
    [ip.cpp, ip.hpp]
2022-11-28 fix Makefile for parallelize
    [top.v]
2022-11-29 fix local variable declarations
    [ros2.cpp]
2022-12-08 fix bug of not released app_data grant when app_reader_cnt <= id
    [ros2.cpp]
2022-12-09 fix udp length write
    [udp.cpp]
2022-12-13 fix raw output packet's length field
    [ip.cpp, ip.hpp, ros2.cpp, udp.cpp, udp.hpp]
2022-12-14 fix byte order, add payload length check
    [udp.cpp]
2022-12-16 fix bug of udp checksum
    [ip.cpp, ros2.cpp, udp.cpp]
2023-01-16 revert to sync reset
    [arbiter.v, arp.v, arp_cache.v, arp_eth_rx.v, arp_eth_tx.v, axis_adapter.v, axis_async_fifo.v, axis_gmii_rx.v]
2023-01-20 changed to async reset
    [arbiter.v, arp.v, arp_cache.v, arp_eth_rx.v, arp_eth_tx.v, axis_adapter.v, axis_async_fifo.v, axis_async_fifo_adapter.v]
2023-01-23 fix floating input and mixed assignment
    [arp_cache.v, verilog_ethernet.v]
2023-01-26 fix unconnected ports, remove timescale directives
    [arbiter.v, arp.v, arp_cache.v, arp_eth_rx.v, arp_eth_tx.v, axis_adapter.v, axis_async_fifo.v, axis_async_fifo_adapter.v]
2023-02-02 fix about enable signal
    [axis_async_fifo.v]
2023-02-21 fix multiple assignment to same register
    [axis_async_fifo.v]
2023-02-22 remove unused wires
2023-02-28 Revert "remove multiple assignment"
    This reverts commit fb3425d9119dee05535d9542fca06d2ce28a8d98.
    [axis_async_fifo.v, axis_gmii_tx.v]
2023-02-28 Revert "fix multiple assignment to same register"
    This reverts commit 712c364792088c817fbc3750be9c6b09904a7767.
    [axis_async_fifo.v, axis_gmii_tx.v]
2023-07-04 replace lfsr.v with upstream latest (4507651) because Xcelium simulation not worked
    [lfsr.v]
2023-07-04 fix about array init
    [axis_async_fifo.v]
2023-07-06 disable array reset on FPGA to reduce logic usage
    [axis_async_fifo.v]
2023-08-25 add ros2_eth adapter modules to replace HLS module (ip_tx_rx)
    [ros2_eth_rx_adapter.v, ros2_eth_tx_adapter.v, ros2_ether.v]
2023-08-25 fix attributes and succeeded to synthesis on CWB
    [endpoint.hpp, hls.hpp, ip.cpp, ros2.cpp, ros2.hpp, sedp.cpp, spdp.cpp, udp.cpp]
2023-08-25 remove ethernet sample project
2023-08-30 fix prototype decl.
2023-10-11 suppress warnings of case statement (cwb)
2023-10-16 Revert "remove ethernet sample project"
    This reverts commit 855f82677346cf47899e71494425aae9a4d599f8.
    [arty_a7_eth.xdc]
2023-12-04 use fifo to pass app_data, fix enable check logic
    [app.cpp, app.hpp, ros2.cpp, ros2.hpp, sedp.cpp, sedp.hpp, spdp.cpp, spdp.hpp]
2023-12-06 fix port mode for CWB
    [ros2.cpp]
2023-12-06 fix scheduling_block, port_mode warn, unused vars
    [ros2.cpp]
2023-12-06 fix ports for CWB
    [ros2_ether.v]
2024-01-24 tidy & fix example
    [arty_a7_eth.xdc, ros2_ether.v, top.v]
2024-01-25 move, rename files and fix path
    [arty_a7_eth.xdc, top.v]
2024-01-25 fix include of config header
    [arbiter.v, arp.v, arp_cache.v, arp_eth_rx.v, arp_eth_tx.v, axis_adapter.v, axis_async_fifo.v, axis_async_fifo_adapter.v]
2024-01-25 fix to build example
    [app.hpp, hls.hpp, top.v]
2024-01-26 introduce TRACE macro
2024-02-05 fix TRACE macro
2024-02-05 fix length check in ip.cpp, improve error report
    [ip.cpp]
2024-02-14 fix gray code calc bug caused by integer width change
    [axis_async_fifo.v]
2024-02-19 fix UDP port check of received RTPS packet
    [sedp.cpp, spdp.cpp]
2024-02-20 fix transmission stop bug when subscriber is disabled
    [ros2.cpp]
2024-02-20 shorten tx_period due to discovery problem (FastRTPS on Linux)
    [top.v]
2024-03-04 fix attribute of sub_app_data
    [ros2.cpp]
2024-03-04 fix ports for cwb top
    [ros2rapper.v]
2024-03-08 fix port calculation macro
    [rtps.hpp]
2024-03-15 fix about app data length at app_writer
    [app.cpp]
2024-03-19 add new port to skip IP checksum validation
    [ip.cpp, ip.hpp, ros2.cpp, ros2.hpp]
2024-04-01 fix about sub_app_data req/rel signals
    [app.cpp, app.hpp, ros2.cpp, ros2rapper.v]
2024-04-01 move state change statements to outside of switch statement (now works on FPGA, Vitis HLS synthesis bug?)
    [udp.cpp]
2024-04-02 Revert "improve critical path"
    This change breaks UDP receive function (Vitis HLS's bug?).
    This reverts commit 066e3774f65187d666f8d9212c538771c58b413c.
    [udp.cpp]
2024-04-02 fix length check of app data
    [app.cpp]
2024-04-02 fix UDP send message
    [top.v]
2024-04-10 use reset synchronizer for phy tx/rx clock
    [mii_phy_if.v]
2024-04-19 remove FIFOs at ros2_in to prevent bug when fifo R/W performed same cycle
    [app.cpp, app.hpp, ros2.cpp, sedp.cpp, sedp.hpp, spdp.cpp, spdp.hpp]
2024-04-20 fix packet type select logic
    [ros2.cpp]
2024-04-25 transform if statement to prevent wrong synth on CWB
    [ros2.cpp]
2024-04-30 transform if statement to prevent wrong synth on CWB (not merged properly...)
    [ros2.cpp]
2024-05-02 add dummy output ports for workaround of CWB bug
    [ros2.cpp]
2024-05-13 Skip RTPS minor version check
    [rtps.cpp]
2024-05-16 fix bug of not sending ACKNACK
    [ros2.cpp]
2024-05-21 fix to prevent long routing time
    [ros2.cpp]
2024-05-23 fix offset check of sedp_reader()
    [sedp.cpp]
2024-05-24 add acknack_req print on csim
2024-05-24 fix problem that acknack_req is not changed
    [sedp.cpp]
2024-05-24 Revert "fix elapsed check"
    This reverts commit 54387365682c7244c126f994475b954285378cc3.
    [ros2.cpp]
2024-05-24 fix problem that timer will not elapsed
    [ros2.cpp]
2024-05-24 fix TX scheduler to avoid excessive timer reset
    [ros2.cpp]
2024-05-27 fix bit-width of tx_cnt_elapsed (possible range is 0-4)
    [ros2.cpp]
2024-05-27 fix timer reset logic
    [ros2.cpp]
2024-05-28 fix TX scheduler to improve raw udp send delay
    [ros2.cpp]
2024-05-29 fix zero clear range
    [app.cpp, ros2.cpp, sedp.cpp, spdp.cpp]
2024-05-29 Revert "fix zero clear range"
    This reverts commit 192d5be1ceaabfe2d004e11275472c412ba1ba87.
    [app.cpp, ros2.cpp, sedp.cpp, spdp.cpp]
2024-05-29 fix zero clear range of raw udp
    [ros2.cpp]
2024-05-29 fix bug that app_seqnum is not incremented
    [ros2.cpp]
2024-05-30 remove inline pragma to fix app writer packet lost problem (Vitis HLS's bug?)
    [ros2.cpp]
2024-05-30 add tx_progress for each packet type (to prevent weird behavior of tx_progress)
    [ros2.cpp]
2024-05-30 Revert "add tx_progress for each packet type (to prevent weird behavior of tx_progress)"
    This reverts commit f5a1f1b45308905b710050e41ddcd7ee35d8a2a6.
    [ros2.cpp]
2024-05-30 shorten scheduling block code
    [ros2.cpp]
2024-05-30 fix clock boundary macro
    [hls.hpp, ros2.cpp]
2024-05-30 add clock boundary after asserting signal of counter reset
    [ros2.cpp]
2024-06-03 Revert "remove inline pragma to fix app writer packet lost problem (Vitis HLS's bug?)"
    This reverts commit 520e66a5ff158a228c526c4b2c51a1ced8e230cf.
    [ros2.cpp]
2024-06-14 insert register to memory port to improve timing between periphclk/ros2clk on ASIC (CWB)
2025-06-23 use volatile=YES attribute instead of volatile qualifier to prevent CWB error (volatile with sc_uint<> is not supported)
    [app.cpp, app.hpp, hls.hpp, ros2.cpp, udp.cpp, udp.hpp]
2025-06-24 Fix port definition of ros2.
    [ros2.cpp]
2025-07-01 Modify a switch statement. Use unrolled for-loop instead.
2025-07-03 Fix the gateway IP address in examples/test-1KB-pu-sub/rtl/ros2_module.v.
    [ros2_module.v]
2025-07-10 Fix a incorrect condition.
    [ros2.cpp]
2025-07-30 Fix bit-widths of counters.
    [ros2rapper.v]
2025-08-13 Always reset the counter for SPDP when ROS2rapper sends a SPDP message.
    [ros2.cpp]
2025-08-18 Modify ports for handshake: wire ros2_pub_app_data_req_{0,1,2,3} -> wire [3:0] ros2_pub_app_data_req, etc.
2025-08-19 Fix a clock name.
    [top.v]
2025-08-20 Fix a cyber attribute.
    [app.cpp]
2025-08-21 Rename a wire and modify the code.
2025-08-21 Fix a port name.
    [ros2rapper.v]
2025-08-22 fix about ROS2CLK_HZ parameter
    [ros2_ether.v, ros2_module.v, top.v]
2025-08-22 Change wire names: *_ap_vld -> *_we
2025-08-28 Fix protocol region code.
    [ros2.cpp]
2025-09-02 Rename wires and registers.
2025-09-02 Move resetting of the counters outside of the for-loops
    [ros2.cpp]
2025-09-05 Fix port names: *_we -> *_valid
    [ros2_ether.v, ros2_module.v, ros2rapper.v, top.v]
2025-10-03 Fix the include guard
    [message_metadata.hpp]
2025-10-06 Skip sending a raw UDP packet when rawudp_txbuf_grant is not asserted
    [ros2_sender.cpp]
2025-10-06 Reset the interval counter after sending a packet in ros2_sender
    [ros2_sender.cpp]
2025-10-07 Designate "register" to avoid a timing loop
    [ros2.cpp]
2025-10-07 Reset the interval counter after sending message metadata in ros2_main
    [ros2.cpp, ros2_sender.cpp, ros2rapper.v]
2025-10-08 Fix a bug: app_writer_entity_id_list -> app_reader_entity_id_list
    [ros2.cpp]
2025-10-08 Fix tx raw UDP payload length
    [ros2_sender.cpp]
2025-10-24 Update sedp_reader and tests, and fix bug
    [ros2.cpp, ros2_receiver.hpp, sedp.cpp, sedp.hpp]
2025-10-27 Fix a type name
    [ros2_receiver.cpp]
2025-10-27 Fix a bug in sedp_reader
    [ros2.cpp, sedp.cpp]
2025-10-31 Avoid multiple return statements
    [ros2.cpp]
2025-11-04 Fix the verilog code
    [ros2_module.v, top.v]
2025-11-04 Fix a signal name
    [top.v]
2025-11-04 Fix the definition of ros2_pub_app_data
    [ros2_module.v]
2025-11-10 Fix conditions in ros2_in_add_new_app_endpoint
    [ros2.cpp]
2025-11-18 Add a cyber attribute async_reset_port to avoid an error in CWB
    [ros2_sender.cpp]
2025-11-26 fix all examples about sedp_reader_tbl_mem
    [ros2_module.v, top.v]
2025-11-26 Use the active-low and asynchronous reset, and reset all registers
    [axis_mux.v]
2025-11-26 fix wire name
2025-11-26 fix clock/reset wire name
    [ros2_module.v]
2025-11-26 insert 2-stage FF synchronizer by CWB attribute (w/o ros2_cnt_*, *_rel/req/grant)
2025-11-27 Fix the memory read condition
    [raw_eth_tx_adapter.v]
2025-11-28 Reset registers if the module is disabled
    [raw_eth_tx_adapter.v]
2025-11-28 Revert "insert 2-stage FF synchronizer by CWB attribute (w/o ros2_cnt_*, *_rel/req/grant)"
    This reverts commit 02adb7b7e3cca83464586e77c087df85ddc11d7d.
    [hls.hpp, ros2.cpp, ros2_receiver.cpp, ros2_sender.cpp]
2025-12-02 add register to axi_stream port to avoid combinational-loop
    [ros2.cpp]
2025-12-03 Fix bugs and add comments.
    [raw_eth_rx_adapter.v]
2025-12-03 Fix port directions from input to output
    [ros2_ether.v]
2025-12-04 Fix rx_raw_eth_udp_payload_len_reg UDP header length was included
    [top.v]
2025-12-08 Add raw ether frame echo back to test-1KB-pub-sub
2025-12-10 Add register to avoid a timing loop
    [ros2_receiver.cpp]
2025-12-11 Change clock frequency for CWB circuits: 40MHz -> 25MHz
2025-12-12 Fix a clock signal name
    [top.v]
2025-12-15 Implement app_reader_tbl as RAM
    Something goes wrong in test_sedp_reader_2 and test_remove_endpoints
    [endpoint.hpp, remove_endpoints.cpp, remove_endpoints.hpp, ros2.cpp, ros2.hpp]
2025-12-15 Fix typo and test_remove_endpoints
    [remove_endpoints.cpp]
2025-12-15 Fix an index of app_reader_tbl in find_unused_and_matched_app_endpoint
    [ros2.cpp]
2025-12-15 Modify a variable name: add_new_endpoint → find_new_endpoint in ros2_in
2025-12-17 fix register reset of FPGA target
    [udp_checksum_gen.v]
2025-12-22 Change the order of case statements in ros2_in
2025-12-22 Write code for SEDP twice in ros2_in
    Workaround for CWB
    [ros2.cpp]
2025-12-23 Use asynchronous and active-low reset
    [ip_mux.v]
2025-12-24 Add missing port "ros2_vendor_id"
    [top.v]
2025-12-28 change reg/wire name (rom --> ram)
2026-01-16 Revert "Write code for SEDP twice in ros2_in"
    This reverts commit 3daa2a9af1bf572b5beae24622cd1e60299631ee.
    [ros2.cpp]
2026-01-16 Revert "Change the order of case statements in ros2_in"
    This reverts commit 034a09d17a44552174a29f7ff4e29da9d3269d46.
    [ros2.cpp]
2026-01-21 insert double FF synchronizer
2026-01-30 Reset drop_frame_reg at the end of each frame
    [axis_async_fifo.v, test_axis_async_fifo.sv, test_raw_eth_rx_adapter.sv]
2026-03-25 Fix a cyber attribute
    [ros2_receiver.cpp]
2026-04-01 Create test_udp_ip_in and fix a bug.
    purge pending info after sending data.
    [ip.cpp, udp_ip_in.cpp]
2026-04-01 Fix copyright messages and include guards
    [app_reader.cpp, app_reader.hpp, pre_ip_in.cpp, pre_ip_in.hpp, rtps_sbm_data_in.cpp, rtps_sbm_data_in.hpp, rtps_sbm_heartbeat_in.cpp, rtps_sbm_heartbeat_in.hpp]
2026-04-03 Fix a member name: used -> is_used.
    [udp_ip_in.cpp]
2026-04-06 Fix the byte order of ros2_node_udp_port.
    [ros2rapper.v]
2026-04-08 Update "ROS2rapperインターフェース解説書.pdf"
